Inverated/CAD/ama_notes.txt

I: 543                                         ~=====~ ~======= 
II: 543 + 41 + 5 = 589 (has bulge, losing 32cm) ====== =======<

OK. I'm wondering if the sails are big enough. what do you think?  At the moment, we two sails each 4.5m x 4.5m for a boat of LOA 9m.

300 (II)  343(I)  289
 <=====< ~====== =====>
