Inverated/CAD/docs/index.md

---
layout: default
title: Solar Proa - Wind-solar-powered Outrigger Boats
---

<div style="margin-bottom: 3em;">
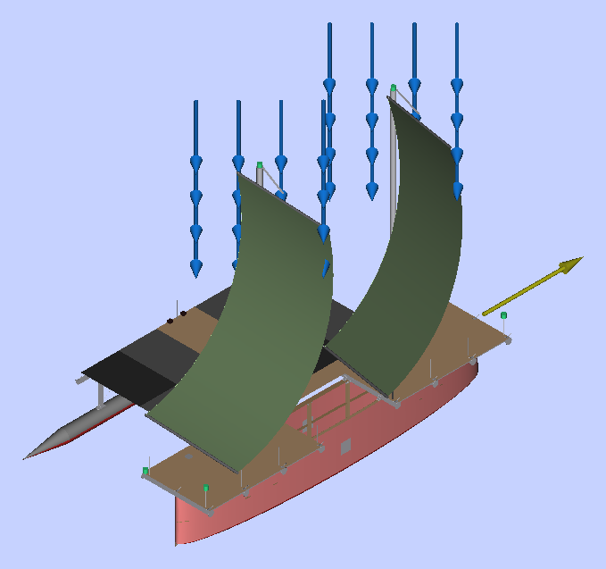
[picture p2: docs/renders/rp2.closehaul.render.isometric.png]
Roti Proa II - Solar-Electric Day Tourism Vessel
  
  <p style="text-align: center; color: #666; font-size: 0.9em; margin-top: 0.5em;">Roti Proa II - 9m solar-electric day tourism vessel</p>
</div>

## At a glance

Project _Solar Proa_ is developing wind-solar-powered hybrid vessels for carbon-neutral small-scale tropical maritime transport, exploration, and tourism.
The completion of our 9-meter minimal viable product _Roti Proa II_ is targeted for mid-2026 and strategic partnerships are available for commercial validation.

---

## The vision

Electric vehicle adoption across Asia has created new expectations for quiet, clean transportation - expectations that extend to maritime sector. Project Solar Proa is bringing carbon-neutral propulsion to water transport, island-hopping, snorkeling, and diving tourism with vessels that combine:

- **Traditional Design** - Inspired by Austronesian outrigger proas and Indonesian sailing 
- **Modern Engineering** - Parametric CAD design, aluminum construction, and efficient electric propulsion
- **Renewable Energy** - on-board photovoltaic energy harvesting with 4kW solar arrays providing continuous zero-emission operation in combination with traditional sails

---

## Our Vessels

<div style="display: grid; grid-template-columns: repeat(auto-fit, minmax(250px, 1fr)); gap: 2em; margin: 2em 0;">
  <div style="border: 1px solid #ddd; padding: 1.5em; border-radius: 8px;">
    <h3>Roti Proa I</h3>
    <p><strong>Status:</strong> Completed & Tested (2025)</p>
    <p><strong>Size:</strong> 4.2m prototype</p>
    <p><strong>Achievement:</strong> Proof of concept validated in Singapore waters</p>
    <p><a href="{{ '/rp1.html' | relative_url }}">View Details & Renders →</a></p>
  </div>
  
  <div style="border: 1px solid #ddd; padding: 1.5em; border-radius: 8px; background: #f8f8f8;">
    <h3>Roti Proa II</h3>
    <p><strong>Status:</strong> Under Construction</p>
    <p><strong>Size:</strong> 9m day tourism vessel</p>
    <p><strong>Capacity:</strong> 4 passengers + 2 crew</p>
    <p><strong>Target:</strong> June 2026 completion</p>
    <p><a href="{{ '/rp2.html' | relative_url }}">View Details & Renders →</a></p>
  </div>
  
  <div style="border: 1px solid #ddd; padding: 1.5em; border-radius: 8px;">
    <h3>Roti Proa III</h3>
    <p><strong>Status:</strong> Design Phase</p>
    <p><strong>Size:</strong> 13m multi-day vessel</p>
    <p><strong>Capacity:</strong> 5-6 passengers</p>
    <p><strong>Target:</strong> 2027 validation</p>
    <p><a href="{{ '/rp3.html' | relative_url }}">View Details & Renders →</a></p>
  </div>
</div>

---

## Why Tropical Southeast Asia?

**Exceptional solar irradiation** makes the region ideally suited for sustainable maritime propulsion. Our designs optimize traditional outrigger configurations to maximize solar panel area while maintaining excellent sailing characteristics.

The shunting, single-outrigger layout provides:
- Ample space for solar arrays between hull and outrigger
- Sail positioning that avoids casting shadows on panels
- Superior stability and efficiency for safe hybrid propulsion

---

## Commercial Opportunities

**Eco-Tourism Applications:**
- Short-distance passenger transport
- Island-hopping and coastal exploration
- Snorkeling and diving expeditions  
- Educational sailing experiences
- Wildlife observation cruises

**Operational Advantages:**
- Zero fuel costs and carbon emissions
- Significantly lower maintenance than diesel
- Quiet operation enhancing wildlife experiences
- Regulatory advantages from green certifications

**Market Position:**
At 10 knots under motor power, Roti Proa II targets the contemplative pace of eco-tourism - where the journey itself is part of the value proposition.

---

## Technical Innovation

All vessel designs are created using **parametric CAD modeling in FreeCAD and Python**, enabling:

- Novel boat designs optimized for solar-wind-hybrid propulsion
- Continuous power and weather monitoring for accurate arrival time prediction
- Rapid design iteration and optimization, version control and design transparency
- Open-source accessibility for educational purposes

**[Explore the CAD Models →]({{ '/downloads' | relative_url }})** | **[Under the Hood →]({{ '/technical.html' | relative_url }})**

---

## Current Status & Timeline

**Q1 2026:** Main hull delivery (9m Roti Proa II)  
**Q2 2026:** Final assembly and sea trials  
**Q3 2026:** Commercial validation with strategic partners  
**2027+:** Pilot production and 13m vessel development

---

## Partnerships

We are proud to work with [Dexteritas Pte Ltd](https://dexmarine.com/) also known as Dexmarine,
our electric marine propulsion partner who sponsors the electric propulsion
system for Roti Proa II.

<div style="margin-bottom: 3em;">
  Dexmarine - Marine Supply Service
</div>

We welcome further strategic partners for:

- **Field testing collaboration** and operational feedback
- **Joint development** of eco-tourism protocols
- **Co-branding opportunities** for sustainability leadership
- **CSR alignment** through maritime innovation support
- **Solar power systems** for exploring sustainable maritime transport

Partnership structures can be flexibly tailored to organizational priorities.

---

## Project Team

Project Solar Proa is a student project conducted at the School of Computing,
National University of Singapore.

**Team Members:**

- Chong Yew Mun Luke, Computer Science, MComp 2026

- Vikram Goyal, Computer Science, BComp 2027

- Kor Qian Fu, Business AI Systems, BComp 2028

- Lim Jia Yi (Julia), Business AI Systems, BComp 2028

- Ong Miao Ying, Clara, Robotics & Machine Intelligence, Second Major in Innovation & Design, BEng 2029 

- Tan Jia Jun, Mechanical Engineering, BEng 2027

**Technical Advisors:**

- [Livio Deltin](https://www.linkedin.com/in/livio-deltin-37936629/), Senior Naval Architect, MEng CEng (Pro Bono)

- [Marcel Eckhardt](https://www.linkedin.com/in/marcel-eckhardt-2607448a/), Electrical Engineer (Pro Bono)

- [Abdullah Farid](https://www.linkedin.com/in/abdullah-engineer/), Engineer, Wärtsilä Marine (Pro Bono)

- Jason Wong, Computer Scientist, BSc (Hons) Computer Science (Pro Bono)

**Project Coordinator:** [Martin Henz](https://www.linkedin.com/in/martin-henz/), Associate Professor, School of Computing, National University of Singapore

---

## Contact

**Email:** henz@nus.edu.sg  
**Institution:** School of Computing, National University of Singapore

---

<div style="text-align: center; padding: 2em 0; color: #666; font-size: 0.9em;">
  <p><em>Combining Southeast Asian maritime traditions with modern sustainable technology</em></p>
</div>
