Inverated/CAD/docs/id/rp2.md

---
layout: default
title: Roti Proa II - Kapal Wisata Harian 9m
description: Kapal Hibrida Bertenaga Angin-Surya untuk Daerah Tropis
lang: id
---

<div style="display: flex; align-items: center; gap: 2em; margin-bottom: 2em; flex-wrap: wrap;">
  <div style="flex: 1; min-width: 400px; max-width: 600px;">
    Roti Proa II Konstruksi
    <p style="font-size: 0.9em; color: #666; margin-top: 0.5em; font-style: italic;">Lambung utama Roti Proa II dalam konstruksi oleh Kim Tuck Huat Pte Ltd, 5/2/2026, Johor Bahru, Malaysia</p>
  </div>
</div>

[← Kembali ke Beranda]({{ '/id/' | relative_url }})

---

## Desain

Roti Proa II adalah kapal daysailer 9m yang menggabungkan rencana badan dasar proa Pasifik dengan material fiberglass, PVC, dan aluminium untuk mencapai konsep kapal yang dapat dikonfigurasi dan diskalakan.

**[Lihat Spesifikasi Desain Lengkap →]({{ '/id/design_rp2.html' | relative_url }})**

**Konstruksi Lambung:**
- Konstruksi fiberglass profesional oleh pembuat kapal Singapura
- Dioptimalkan untuk efisiensi propulsi listrik
- Pengiriman dijadwalkan pertengahan Februari 2026

**Sistem Surya-Listrik:**
- 8 x panel surya 500W (total 4kW)
- Sistem listrik 48V
- Motor listrik 4kW yang disponsori
- Manajemen baterai terintegrasi

**Rig Layar:**
- Dua tiang aluminium tanpa stay
- Layar persegi panjang terinspirasi tanja tradisional
- Konfigurasi shunting untuk kondisi tropis
- Kemampuan propulsi cadangan

**Cadik (Ama):**
- Konstruksi balok silang aluminium (aka)
- Konstruksi pelampung pipa PVC
- Pemasangan panel surya yang dioptimalkan
- Stabilitas yang ditingkatkan untuk kenyamanan penumpang

---

## Stabilitas & Daya Apung

Stabilitas kapal telah dianalisis menggunakan perhitungan kesetimbangan daya apung otomatis dan kurva GZ.

**[Lihat Analisis Stabilitas & Daya Apung Lengkap →]({{ '/id/stability_rp2.html' | relative_url }})**

| Parameter | Nilai | Deskripsi |
|---|---|---|
| Sarat | {{ site.data.rp2_beaching_buoyancy.equilibrium.z_offset_mm }} mm | Kedalaman di bawah garis air pada kesetimbangan |
| Lengan penegak maks | {{ site.data.rp2_beaching_gz.summary.max_gz_m | times: 100 | round: 0 }} cm | Pada kemiringan {{ site.data.rp2_beaching_gz.summary.max_gz_angle_deg }}° |
| Sudut capsize | {{ site.data.rp2_beaching_gz.summary.capsize_angle_deg }}° | Menjauhi ama |
| Sudut turtle | {{ site.data.rp2_beaching_gz.summary.turtle_angle_deg }}° | Menuju ama |
| Periode roll | {{ site.data.rp2_beaching_gz.natural_periods.roll_period_s }} s | Perkiraan kasar |
| Periode pitch | {{ site.data.rp2_beaching_gz.natural_periods.pitch_period_s }} s | Perkiraan kasar |
| Periode heave | {{ site.data.rp2_beaching_gz.natural_periods.heave_period_s }} s | Perkiraan kasar |

---

## Validasi Struktural

Integritas struktural kapal telah divalidasi di bawah beberapa skenario beban termasuk beban statis, dampak gelombang, gaya angin, dan operasi crane. Semua tes lulus dengan faktor keamanan melebihi minimum yang diperlukan yaitu 2,0.

**[Lihat Laporan Keselamatan Struktural Lengkap →]({{ '/id/validation_rp2.html' | relative_url }})**

| Tes | Faktor Keamanan | Hasil |
|-----|---|---|
| Ama tergantung (lentur aka) | {{ site.data.rp2_beaching_validate_structure.tests[0].summary.strong_axis.safety_factor }} | {{ site.data.rp2_beaching_validate_structure.tests[0].summary.strong_axis.result }} |
| Beban titik aka (kru berdiri) | {{ site.data.rp2_beaching_validate_structure.tests[1].summary.safety_factor }} | {{ site.data.rp2_beaching_validate_structure.tests[1].summary.result }} |
| Satu ujung ditopang (lentur spine) | {{ site.data.rp2_beaching_validate_structure.tests[2].summary.safety_factor }} | {{ site.data.rp2_beaching_validate_structure.tests[2].summary.result }} |
| Beban angin tiang (25 knot) | {{ site.data.rp2_beaching_validate_structure.tests[3].summary.safety_factor }} | {{ site.data.rp2_beaching_validate_structure.tests[3].summary.result }} |
| Penopang diagonal (lateral) | {{ site.data.rp2_beaching_validate_structure.tests[4].summary.min_safety_factor }} | {{ site.data.rp2_beaching_validate_structure.tests[4].summary.result }} |
| Hantaman gelombang (vertikal) | {{ site.data.rp2_beaching_validate_structure.tests[5].summary.min_safety_factor }} | {{ site.data.rp2_beaching_validate_structure.tests[5].summary.result }} |
| Hantaman gelombang frontal | {{ site.data.rp2_beaching_validate_structure.tests[6].summary.min_safety_factor }} | {{ site.data.rp2_beaching_validate_structure.tests[6].summary.result }} |
| Hantaman gelombang samping | {{ site.data.rp2_beaching_validate_structure.tests[7].summary.min_safety_factor }} | {{ site.data.rp2_beaching_validate_structure.tests[7].summary.result }} |
| Sling pengangkat (crane) | {{ site.data.rp2_beaching_validate_structure.tests[8].summary.min_safety_factor }} | {{ site.data.rp2_beaching_validate_structure.tests[8].summary.result }} |
| Beban gunwale | {{ site.data.rp2_beaching_validate_structure.tests[9].summary.min_safety_factor }} | {{ site.data.rp2_beaching_validate_structure.tests[9].summary.result }} |
| Kecepatan angin angkat ama | {{ site.data.rp2_beaching_validate_structure.tests[10].summary.ama_lift_windspeed_knots }} knot | INFO |

---

## Simulasi Kelistrikan

Sistem kelistrikan dimodelkan sebagai rangkaian DC panel surya–MPPT–baterai–motor. Simulasi menghitung titik operasi kondisi tunak, melakukan pengujian daya dan tingkat daya surya untuk memetakan batas sistem, dan menjalankan profil perjalanan multi-segmen untuk mengevaluasi daya tahan baterai dan batasan pengosongan dalam kondisi realistis.

**[Lihat Pengaturan Kelistrikan Lengkap & Hasil Simulasi →]({{ '/id/electrical_rp2.html' | relative_url }})**

## Status Proyek

**Fase Saat Ini:** Dalam Konstruksi

**Selesai:**
- ✅ Desain CAD detail dan optimasi
- ✅ Pesanan lambung ditempatkan ke pembuat kapal
- ✅ Struktur cadik sedang berlangsung
- ✅ Desain sistem listrik
- ✅ Pengadaan komponen

**Langkah Selanjutnya:**
- Pengiriman lambung (Februari 2026)
- Perakitan akhir (Maret-April 2026)
- Uji coba laut (Mei-Juni 2026)
- Validasi komersial dengan mitra (Q3 2026)

---

[← Kembali ke Beranda]({{ '/id/' | relative_url }}) | [Lihat RP1 →]({{ '/id/rp1.html' | relative_url }}) | [Lihat RP3 →]({{ '/id/rp3.html' | relative_url }})
