Inverated/CAD/docs/id/index.md

---
layout: default
title: Solar Proa - Perahu Cadik Bertenaga Angin-Surya
description: Kapal Hibrida Bertenaga Angin-Surya untuk Daerah Tropis
lang: id
---

<div style="margin-bottom: 3em;">
  Roti Proa II - Kapal Wisata Harian Bertenaga Surya-Listrik
  <p style="text-align: center; color: #666; font-size: 0.9em; margin-top: 0.5em;">Roti Proa II - Kapal wisata harian 9m bertenaga surya-listrik</p>
</div>

## Sekilas

Proyek _Solar Proa_ mengembangkan kapal hibrida bertenaga angin-surya untuk transportasi maritim tropis skala kecil yang ramah lingkungan, eksplorasi, dan pariwisata.
Penyelesaian produk minimal viable 9 meter kami, _Roti Proa II_, ditargetkan pertengahan 2026 dan kemitraan strategis tersedia untuk validasi komersial.

---

## Visi Kami

Adopsi kendaraan listrik di seluruh Asia telah menciptakan ekspektasi baru untuk transportasi yang tenang dan bersih - ekspektasi yang meluas ke sektor maritim. Proyek Solar Proa menghadirkan propulsi bebas karbon untuk transportasi air, wisata pulau, snorkeling, dan wisata selam dengan kapal yang menggabungkan:

- **Desain Tradisional** - Terinspirasi oleh proa cadik Austronesia dan pelayaran Indonesia
- **Rekayasa Modern** - Desain CAD parametrik, konstruksi aluminium, dan propulsi listrik efisien
- **Energi Terbarukan** - Pemanenan energi fotovoltaik di atas kapal dengan panel surya 4kW yang menyediakan operasi bebas emisi berkelanjutan dikombinasikan dengan layar tradisional

---

## Kapal Kami

<div style="display: grid; grid-template-columns: repeat(auto-fit, minmax(250px, 1fr)); gap: 2em; margin: 2em 0;">
  <div style="border: 1px solid #ddd; padding: 1.5em; border-radius: 8px;">
    <h3>Roti Proa I</h3>
    <p><strong>Status:</strong> Selesai & Teruji (2025)</p>
    <p><strong>Ukuran:</strong> Prototipe 4,2m</p>
    <p><strong>Pencapaian:</strong> Bukti konsep tervalidasi di perairan Singapura</p>
    <p><a href="{{ '/id/rp1.html' | relative_url }}">Lihat Detail & Render →</a></p>
  </div>

  <div style="border: 1px solid #ddd; padding: 1.5em; border-radius: 8px; background: #f8f8f8;">
    <h3>Roti Proa II</h3>
    <p><strong>Status:</strong> Dalam Konstruksi</p>
    <p><strong>Ukuran:</strong> Kapal wisata harian 9m</p>
    <p><strong>Kapasitas:</strong> 4 penumpang + 2 kru</p>
    <p><strong>Target:</strong> Selesai Juni 2026</p>
    <p><a href="{{ '/id/rp2.html' | relative_url }}">Lihat Detail & Render →</a></p>
  </div>

  <div style="border: 1px solid #ddd; padding: 1.5em; border-radius: 8px;">
    <h3>Roti Proa III</h3>
    <p><strong>Status:</strong> Fase Desain</p>
    <p><strong>Ukuran:</strong> Kapal multi-hari 13m</p>
    <p><strong>Kapasitas:</strong> 5-6 penumpang</p>
    <p><strong>Target:</strong> Validasi 2027</p>
    <p><a href="{{ '/id/rp3.html' | relative_url }}">Lihat Detail & Render →</a></p>
  </div>
</div>

---

## Mengapa Asia Tenggara Tropis?

**Iradiasi surya yang luar biasa** menjadikan kawasan ini sangat cocok untuk propulsi maritim berkelanjutan. Desain kami mengoptimalkan konfigurasi cadik tradisional untuk memaksimalkan area panel surya sambil mempertahankan karakteristik pelayaran yang sangat baik.

Tata letak shunting dengan cadik tunggal menyediakan:
- Ruang yang luas untuk panel surya antara lambung dan cadik
- Posisi layar yang menghindari bayangan pada panel
- Stabilitas dan efisiensi superior untuk propulsi hibrida yang aman

---

## Peluang Komersial

**Aplikasi Eko-Wisata:**
- Transportasi penumpang jarak pendek
- Wisata pulau dan eksplorasi pesisir
- Ekspedisi snorkeling dan selam
- Pengalaman pelayaran edukatif
- Wisata pengamatan satwa liar

**Keunggulan Operasional:**
- Nol biaya bahan bakar dan emisi karbon
- Perawatan jauh lebih rendah dibanding diesel
- Operasi tenang meningkatkan pengalaman satwa liar
- Keunggulan regulasi dari sertifikasi hijau

**Posisi Pasar:**
Dengan kecepatan 10 knot di bawah tenaga motor, Roti Proa II menargetkan tempo kontemplatif eko-wisata - di mana perjalanan itu sendiri adalah bagian dari proposisi nilai.

---

## Inovasi Teknis

Semua desain kapal dibuat menggunakan **pemodelan CAD parametrik di FreeCAD dan Python**, memungkinkan:

- Desain kapal novel yang dioptimalkan untuk propulsi hibrida surya-angin
- Pemantauan daya dan cuaca berkelanjutan untuk prediksi waktu kedatangan yang akurat
- Iterasi dan optimasi desain yang cepat, kontrol versi dan transparansi desain
- Aksesibilitas sumber terbuka untuk tujuan pendidikan

**[Jelajahi Model CAD →]({{ '/downloads' | relative_url }})** | **[Di Balik Layar →]({{ '/id/technical.html' | relative_url }})**

---

## Status Terkini & Linimasa

**Q1 2026:** Pengiriman lambung utama (Roti Proa II 9m)
**Q2 2026:** Perakitan akhir dan uji coba laut
**Q3 2026:** Validasi komersial dengan mitra strategis
**2027+:** Produksi percontohan dan pengembangan kapal 13m

---

## Kemitraan

Kami bangga bekerja sama dengan [Dexteritas Pte Ltd](https://dexmarine.com/) yang juga dikenal sebagai Dexmarine,
mitra propulsi maritim listrik kami yang mensponsori sistem propulsi listrik
untuk Roti Proa II.

<div style="margin-bottom: 3em;">
  Dexmarine - Marine Supply Service
</div>

Kami menyambut mitra strategis lebih lanjut untuk:

- **Kolaborasi uji lapangan** dan umpan balik operasional
- **Pengembangan bersama** protokol eko-wisata
- **Peluang co-branding** untuk kepemimpinan keberlanjutan
- **Keselarasan CSR** melalui dukungan inovasi maritim
- **Sistem tenaga surya** untuk mengeksplorasi transportasi maritim berkelanjutan

Struktur kemitraan dapat disesuaikan secara fleksibel dengan prioritas organisasi.

---

## Tim Proyek

Proyek Solar Proa adalah proyek mahasiswa yang dilakukan di Sekolah Komputasi,
Universitas Nasional Singapura (School of Computing,
National University of Singapore).

**Anggota Tim:**

- Chong Yew Mun Luke, Computer Science, MComp 2026

- Vikram Goyal, Computer Science, BComp 2027

- Kor Qian Fu, Business AI Systems, BComp 2028

- Lim Jia Yi (Julia), Business AI Systems, BComp 2028

- Ong Miao Ying, Clara, Robotics & Machine Intelligence, Second Major in Innovation & Design, BEng 2029

- Tan Jia Jun, Mechanical Engineering, BEng 2027

**Penasihat Teknis:**

- [Livio Deltin](https://www.linkedin.com/in/livio-deltin-37936629/), Senior Naval Architect, MEng CEng (Pro Bono)

- [Marcel Eckhardt](https://www.linkedin.com/in/marcel-eckhardt-2607448a/), Electrical Engineer (Pro Bono)

- [Abdullah Farid](https://www.linkedin.com/in/abdullah-engineer/), Engineer, Wärtsilä Marine (Pro Bono)

- Jason Wong, Computer Scientist, BSc (Hons) Computer Science (Pro Bono)

**Koordinator Proyek:** [Martin Henz](https://www.linkedin.com/in/martin-henz/), Associate Professor, School of Computing, National University of Singapore

---

## Kontak

**Email:** henz@nus.edu.sg
**Institusi:** School of Computing, National University of Singapore

---

<div style="text-align: center; padding: 2em 0; color: #666; font-size: 0.9em;">
  <p><em>Menggabungkan tradisi maritim Asia Tenggara dengan teknologi berkelanjutan modern</em></p>
</div>
