Inverated/CAD/docs/id/rp1.md

---
layout: default
title: Roti Proa I - Prototipe 4,2m
lang: id
---

<div style="display: flex; align-items: center; gap: 2em; margin-bottom: 2em; flex-wrap: wrap;">
  <div style="flex: 1; min-width: 500px; max-width: 700px;">
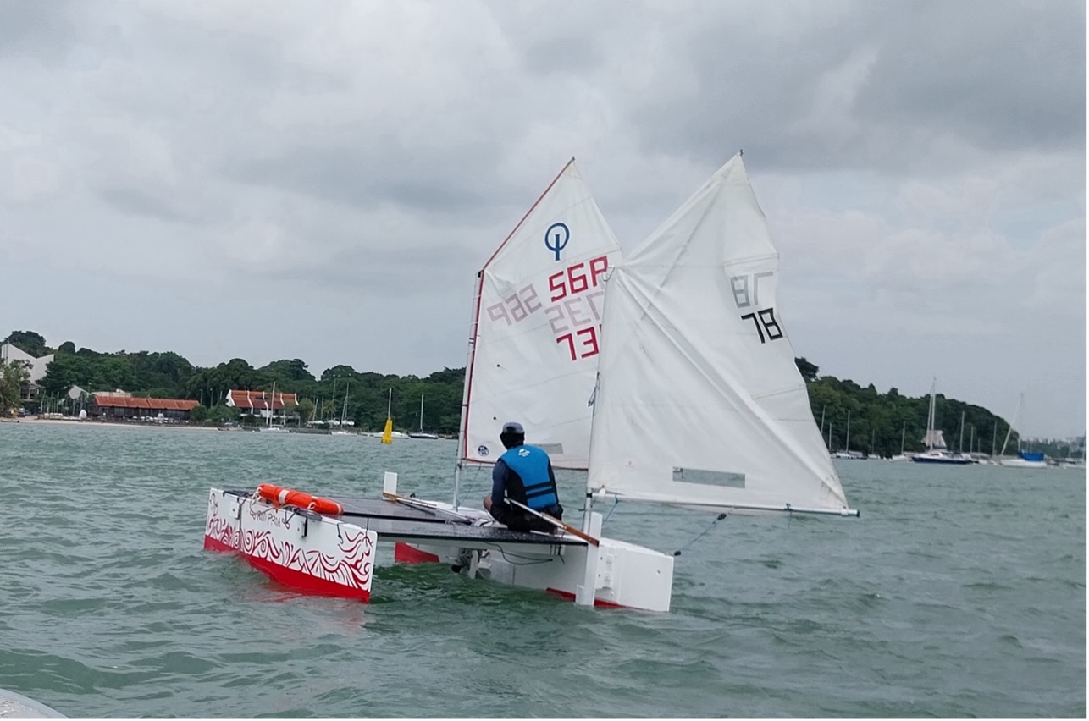
[picture p3: docs/images/rp1.jpg]
Roti Proa I
    
    <p style="font-size: 0.9em; color: #666; margin-top: 0.5em; font-style: italic;">Roti Proa I, dinahkodai oleh Penasihat Solar Proa Abdullah Farid, melakukan uji performa pada 30 Mei 2025</p>
  </div>
</div>

[← Kembali ke Beranda]({{ '/id/' | relative_url }})

---

## Ringkasan

**Status:** ✅ Selesai dan teruji (Desember 2024 - Juni 2025)

Roti Proa I adalah prototipe bukti-konsep kami yang memvalidasi kelayakan menggabungkan desain cadik tradisional dengan propulsi surya-listrik modern di perairan tropis. Kapal 4,2 meter ini berhasil mendemonstrasikan prinsip-prinsip inti yang menginformasikan desain komersial kami yang lebih besar.

**Pencapaian Utama:**
- **Uji coba laut tervalidasi** di perairan Singapura dekat Changi
- **Kecepatan tertinggi:** 6,5 knot (12 km/jam) dengan tenaga listrik
- **Kapasitas surya:** 1 kW puncak (2 panel)
- **Propulsi:** Motor tempel listrik 2 kW
- **Baterai:** 2 x 50 Ah, LiFePO₄
- **Rig layar:** Dua rig sport independen (Optimist) untuk konfigurasi eksperimental

Prototipe ini membuktikan bahwa proa surya layak untuk perairan Asia Tenggara tropis dan memberikan data penting untuk peningkatan skala ke desain Roti Proa II 9 meter.

---

## Publikasi Unggulan

Untuk laporan detail tentang pengembangan, pengujian, dan pelajaran yang dipetik dari Roti Proa I, baca artikel lengkap yang diterbitkan oleh Changi Sailing Club di Singapura:

**[Roti Proa: Perahu Eksperimental Bertenaga Angin dan Surya](https://www.csc.org.sg/2025/07/11/roti-proa-an-experimental-wind-and-solar-powered-boat/)**

Artikel komprehensif ini mencakup:
- Filosofi desain dan pengaruh tradisional
- Proses konstruksi dan pilihan material
- Hasil uji coba laut dan data performa
- Pelajaran yang dipetik untuk pengembangan masa depan
- Tantangan teknis dan solusinya

---

## Spesifikasi Ringkas

| Spesifikasi | Nilai |
|---|---|
| Panjang Keseluruhan (LOA) | 4,2m |
| Lebar | 2,5m |
| Daya Surya | 1kW puncak |
| Daya Motor | Motor tempel listrik 2kW |
| Tipe Baterai | LiFePO₄ |
| Kecepatan Tertinggi | 6,5 knot |
| Kru | 1-2 orang |
| Status | Pengujian selesai Juni 2025 |

---

## Warisan & Dampak

Uji coba Roti Proa I yang sukses memberikan kepercayaan dan data empiris yang diperlukan untuk mengejar pengembangan skala komersial. Prototipe ini mendemonstrasikan bahwa:

✅ Propulsi surya-listrik layak di perairan tropis
✅ Desain cadik tradisional beradaptasi dengan baik terhadap sistem listrik modern
✅ Proa shunting dapat mengintegrasikan panel surya secara efektif
✅ Kombinasi ini menciptakan pengalaman eko-wisata yang menarik

Wawasan ini secara langsung menginformasikan desain Roti Proa II dan memvalidasi pendekatan kami untuk Roti Proa III 13 meter.

---

## Pendanaan & Dukungan

Roti Proa I didanai melalui:
- **Maybank Green Fund:** S$5.000 (melalui NUS Office of Student Affairs)
- **Donasi dan sponsor swasta:** S$7.000
- **Total biaya proyek:** S$12.000

---

[← Kembali ke Beranda]({{ '/id/' | relative_url }}) | [Lihat RP2 →]({{ '/id/rp2.html' | relative_url }}) | [Lihat RP3 →]({{ '/id/rp3.html' | relative_url }})
