Inverated/CAD/docs/images/circuit_diagrams_temp/Sensor Reader V3-Microcontroller.png

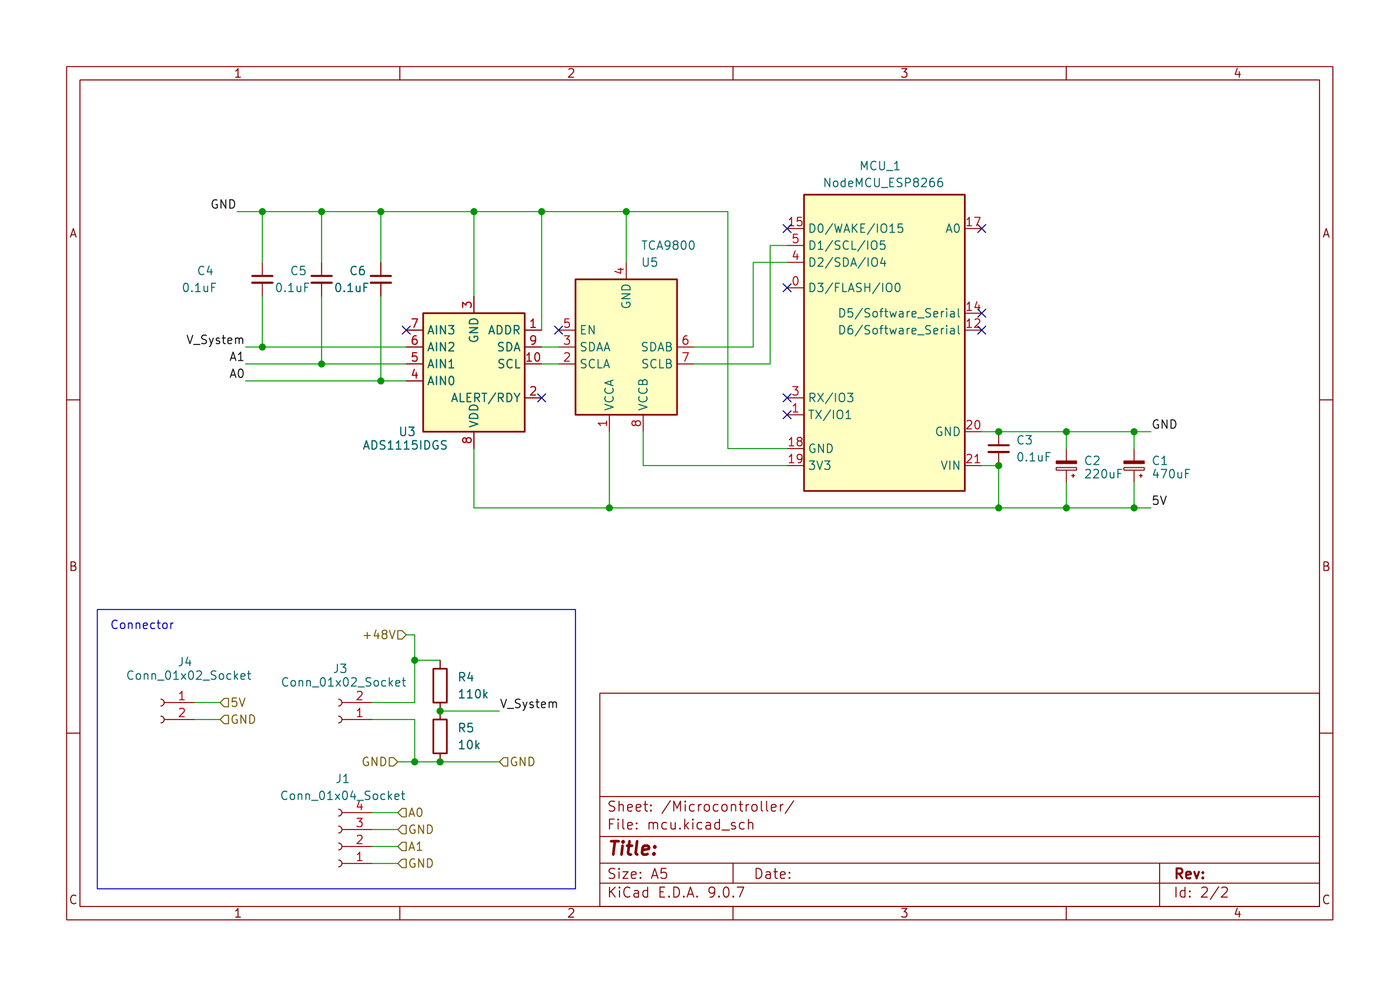
docs/images/circuit_diagrams_temp/Sensor Reader V3-Microcontroller.png
