Inverated/CAD/docs/images/circuit_diagrams_temp/Sensor Reader V3.png

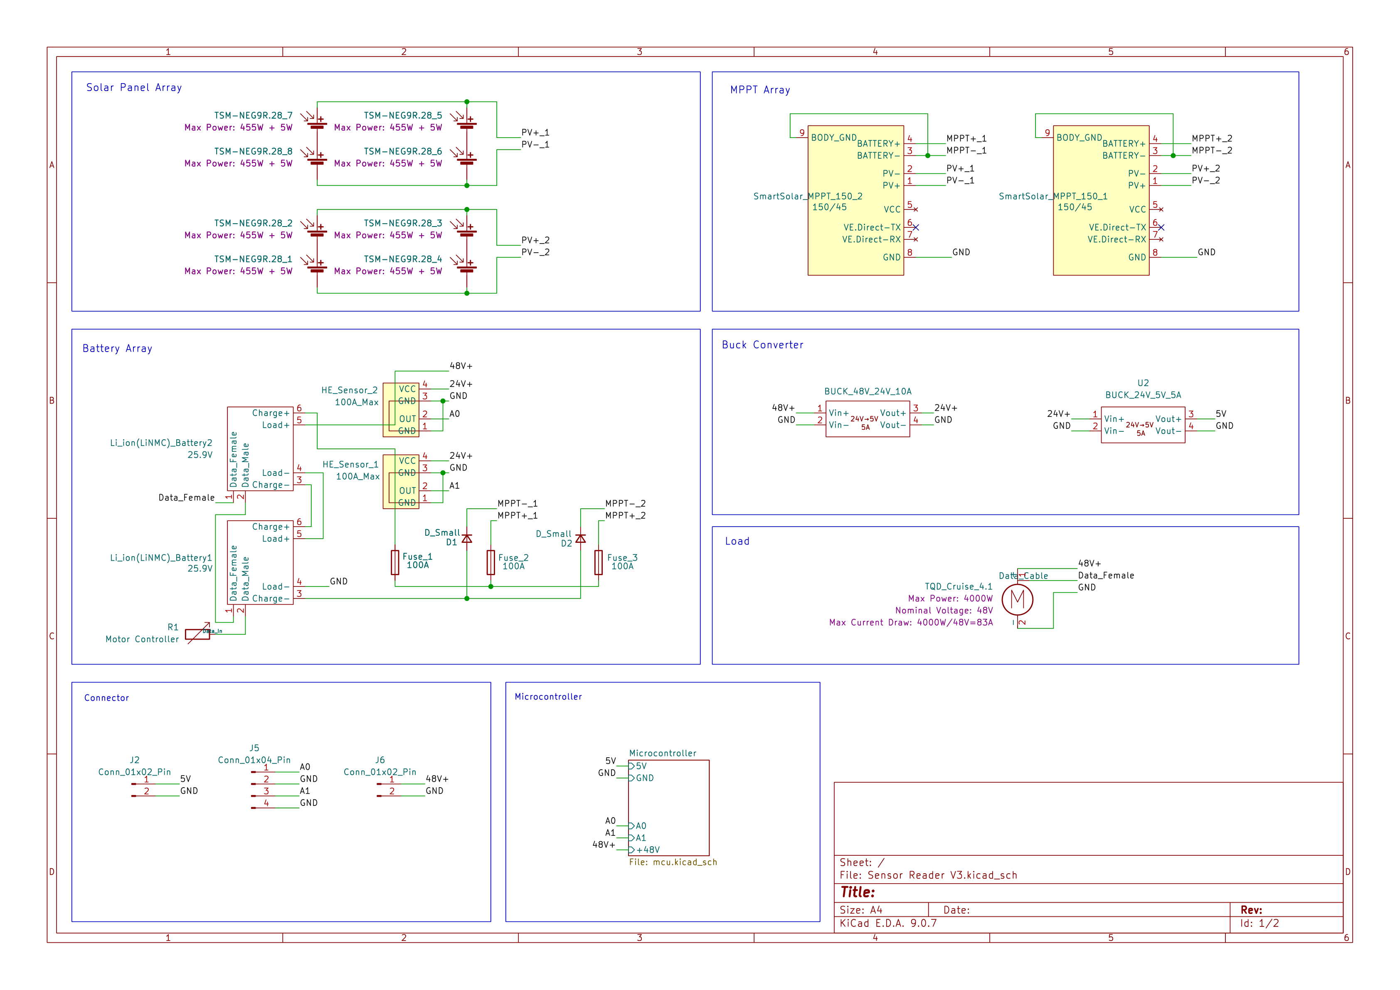
docs/images/circuit_diagrams_temp/Sensor Reader V3.png
