Inverated/CAD/src/circuit_diagram/KiCad/proa_2_circuit_diagram/pdf_converted.png

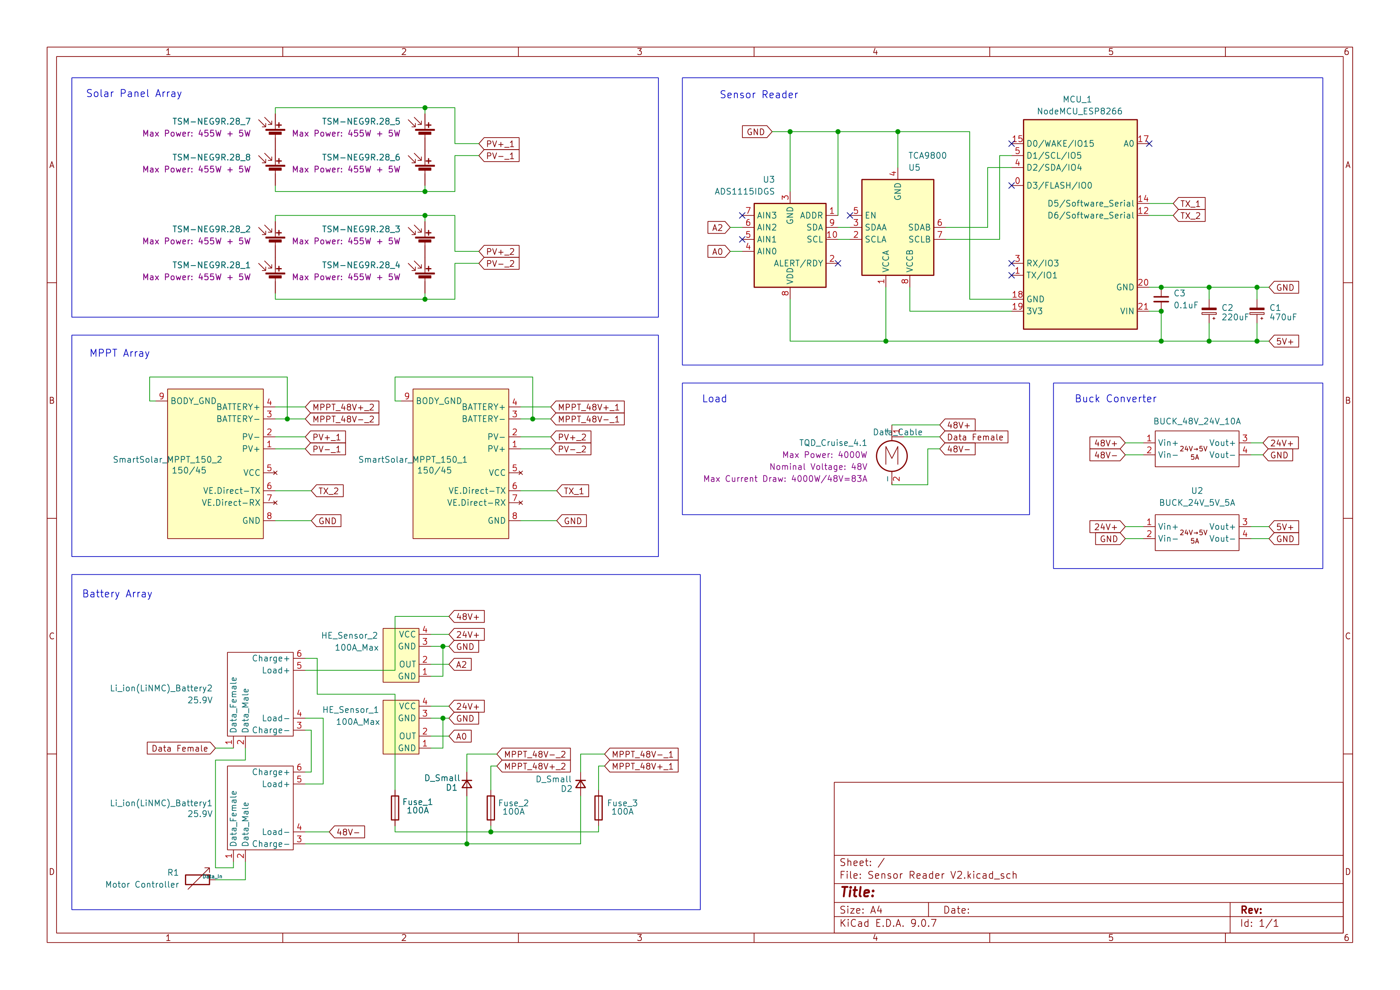
src/circuit_diagram/KiCad/proa_2_circuit_diagram/pdf_converted.png
