Inverated/CAD/docs/downloads/rp2.closehaul.step.step

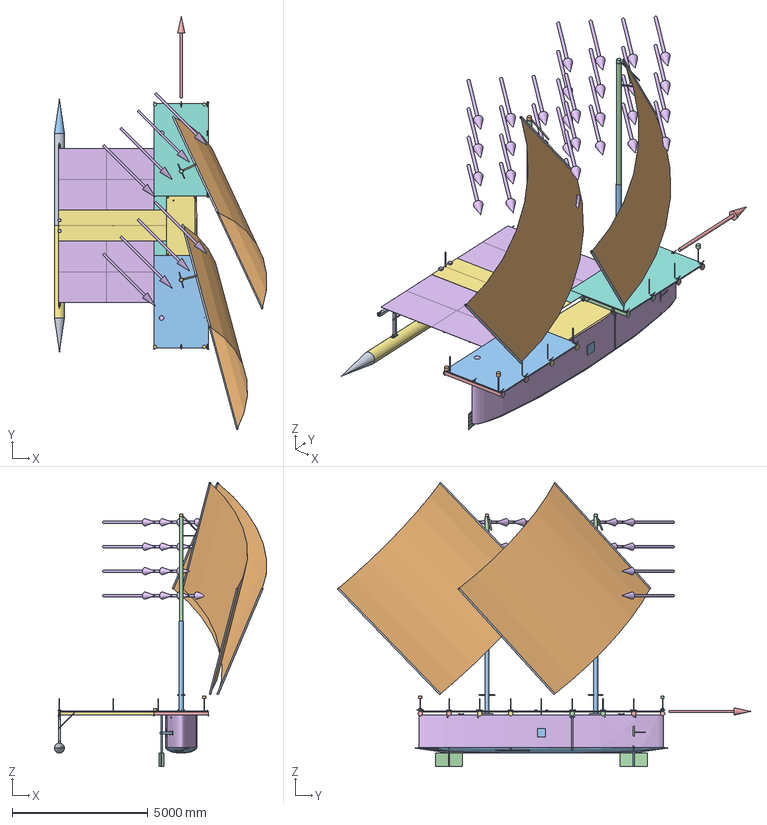
[picture p9: CAD file, 2026-02-18, last stored version]
docs/downloads/rp2.closehaul.step.step
7812.3 x 15208.9 x 10471.8 mm
Overhead__plywood_ x 2
Bottom__fiberglass_bottom_ x 2
Foam_Below_Sole__foam_ x 2
Sole__plywood_ x 2
Air_Inside_Vaka__air_ x 2
Outer_Crossdeck_Stanchion__steel_ x 2
Center_Crossdeck_Stanchion__aluminum_ x 2
Motor_Backing_Plate__aluminum_ x 2
Side_Board_Plate__aluminum_ x 2
X-axis x 24
XY-plane x 24
Aka_1__aluminum_ x 2
Stanchion_1__steel_ x 2
Cleat__steel_ x 2
Frame_1__plywood_ x 2
Bottom_Frame_1__plywood_ x 2
Gusset_clamp_to_aka_right_1__aluminum_ x 2
Gusset_clamp_to_aka_left_1__aluminum_ x 2
Gusset_frame_to_clamp_right_1__aluminum_ x 2
Gusset_frame_to_clamp_left_1__aluminum_ x 2
Gusset_clamp_to_aka_outer_right_1__aluminum_ x 2
Gusset_clamp_to_aka_outer_left_1__aluminum_ x 2
Gusset_frame_to_clamp_outer_right_1__aluminum_ x 2
Gusset_frame_to_clamp_outer_left_1__aluminum_ x 2
Gusset_spine_to_aka_right_1__aluminum_ x 2
Gusset_spine_to_aka_left_1__aluminum_ x 2
Gusset_pillar_to_spine_right_1__aluminum_ x 2
Gusset_pillar_to_spine_left_1__aluminum_ x 2
Gusset_pillar_to_ama_top_right_1__aluminum_ x 2
Gusset_pillar_to_ama_top_left_1__aluminum_ x 2
Gusset_pillar_to_ama_bottom_right_1__aluminum_ x 2
Gusset_pillar_to_ama_bottom_left_1__aluminum_ x 2
Gusset_pillar_to_ama_inside_right_1__aluminum_ x 2
Gusset_pillar_to_ama_inside_left_1__aluminum_ x 2
Aka_2__aluminum_ x 2
Stanchion_2__steel_ x 2
Cleat__steel_001 x 2
Frame_2__plywood_ x 2
Bottom_Frame_2__plywood_ x 2
Gusset_clamp_to_aka_right_2__aluminum_ x 2
Gusset_clamp_to_aka_left_2__aluminum_ x 2
Gusset_frame_to_clamp_right_2__aluminum_ x 2
Gusset_frame_to_clamp_left_2__aluminum_ x 2
Gusset_clamp_to_aka_outer_right_2__aluminum_ x 2
Gusset_clamp_to_aka_outer_left_2__aluminum_ x 2
Gusset_frame_to_clamp_outer_right_2__aluminum_ x 2
Gusset_frame_to_clamp_outer_left_2__aluminum_ x 2
Gusset_spine_to_aka_right_2__aluminum_ x 2
Gusset_spine_to_aka_left_2__aluminum_ x 2
Gusset_pillar_to_spine_right_2__aluminum_ x 2
Gusset_pillar_to_spine_left_2__aluminum_ x 2
Gusset_pillar_to_ama_top_right_2__aluminum_ x 2
Gusset_pillar_to_ama_top_left_2__aluminum_ x 2
Gusset_pillar_to_ama_bottom_right_2__aluminum_ x 2
Gusset_pillar_to_ama_bottom_left_2__aluminum_ x 2
Gusset_pillar_to_ama_inside_right_2__aluminum_ x 2
Gusset_pillar_to_ama_inside_left_2__aluminum_ x 2
Aka_3__aluminum_ x 2
Stanchion_3__steel_ x 2
Cleat__steel_002 x 2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
