Inverated/CAD/src/circuit_diagram/KiCad/proa_2_circuit_diagram/proa_2_circuit_diagram.kicad_pcb

## KiCad design V1.2/v1.2_kicad/v1.2_kicad.kicad_sch

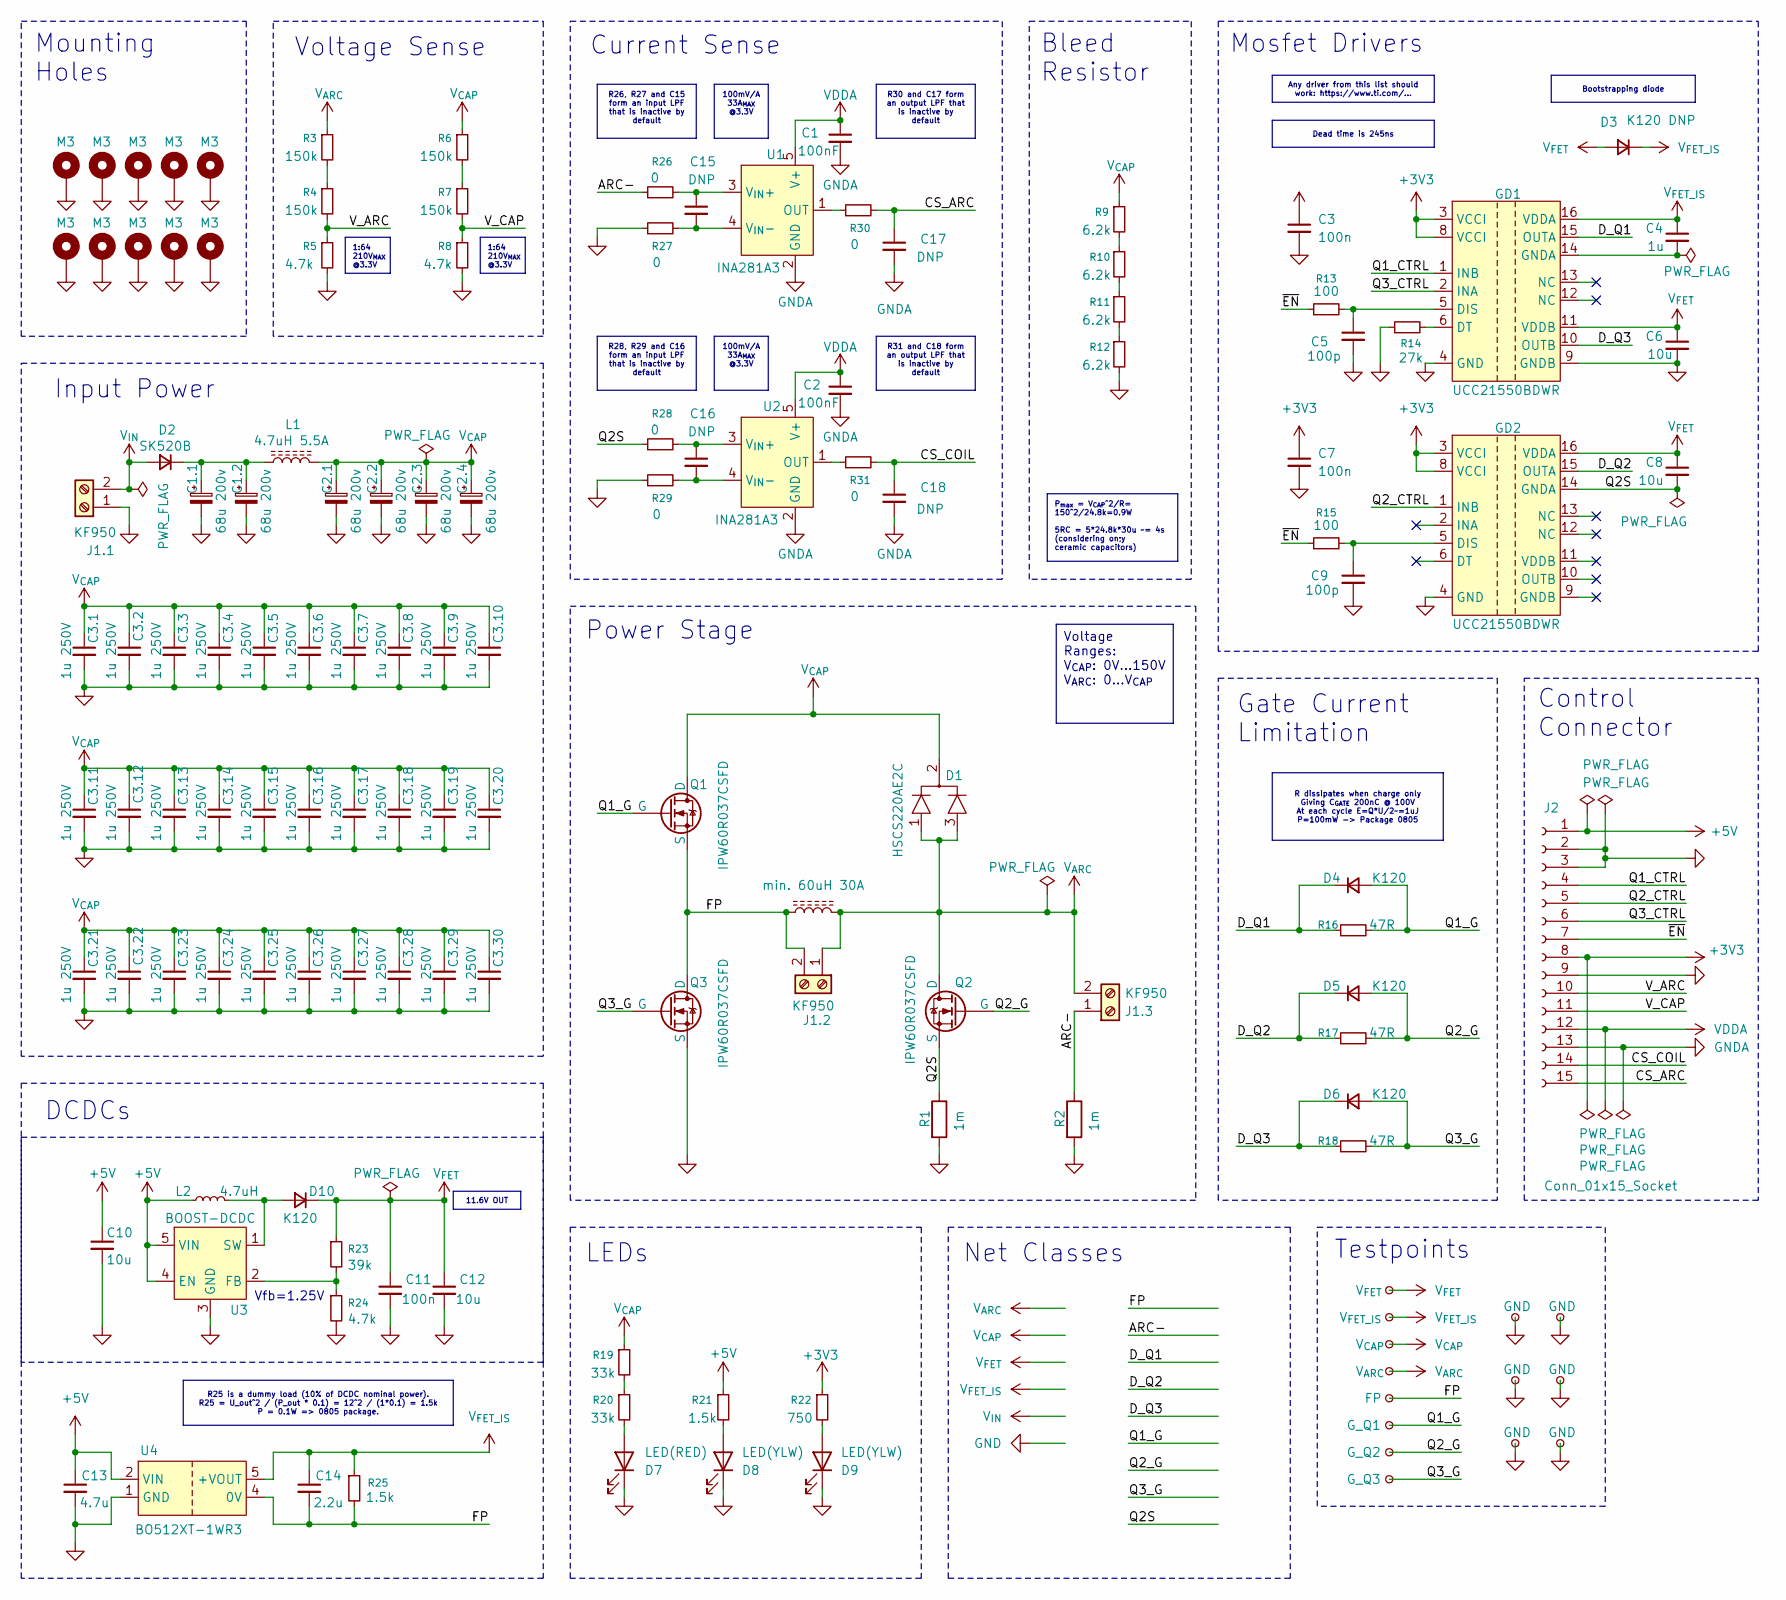
[picture p10: schematic v1.2_kicad.kicad_sch]

Parts:
C1, C2: 100nF
C1.1, C1.2, C2.1, C2.2, C2.3, C2.4: 68u 200v
C3, C7, C11: 100n
C3.1, C3.2, C3.3, C3.4, C3.5, C3.6, C3.7, C3.8, C3.9, C3.10, C3.11, C3.12, C3.13, C3.14, C3.15, C3.16, C3.17, C3.18, C3.19, C3.20, C3.21, C3.22, C3.23, C3.24, C3.25, C3.26, C3.27, C3.28, C3.29, C3.30: 1u 250V
C4: 1u
C5, C9: 100p
C6, C8, C10, C12: 10u
C13: 4.7u
C14: 2.2u
C15, C16, C17, C18: DNP
D1: HSCS220AE2C
D2: SK520B
D3: K120 DNP
D4, D5, D6, D10: K120
D7: LED(RED)
D8, D9: LED(YLW)
GD1, GD2: UCC21550BDWR
H1, H2, H3, H4, H5, H6, H7, H8, H9, H10: M3
J1.1, J1.2, J1.3: KF950
J2: Conn_01x15_Socket
L1: 4.7uH 5.5A
L2: 4.7uH
L3: min. 60uH 30A
Q1, Q2, Q3: IPW60R037CSFD
R1, R2: 1m
R3, R4, R6, R7: 150k
R5, R8, R24: 4.7k
R9, R10, R11, R12: 6.2k
R13, R15: 100
R14: 27k
R16, R17, R18: 47R
R19, R20: 33k
R21, R25: 1.5k
R22: 750
R23: 39k
R26, R27, R28, R29, R30, R31: 0
TP1, TP2, TP3, TP4, TP5, TP6: GND
TP7: V_{FET}
TP8: V_{FET_IS}
TP9: V_{CAP}
TP10: V_{ARC}
TP11: FP
TP12: G_Q1
TP13: G_Q2
TP14: G_Q3
U1, U2: INA281A3
U3: BOOST-DCDC
U4: BO512XT-1WR3

Connections:
+3V3: C3.1, C7.1, GD1.3 (VCCI), GD1.8 (VCCI), GD2.3 (VCCI), GD2.8 (VCCI), J2.8, R22.1
+5V: C10.1, C13.1, J2.1, L2.1, R21.1, U3.4 (EN), U3.5 (VIN), U4.2 (VIN)
ARC-: J1.3.1, R2.1, R26.1
CS_ARC: C17.1, J2.15, R30.2
CS_COIL: C18.1, J2.14, R31.2
D_Q1: D4.1 (K), GD1.15 (OUTA), R16.1
D_Q2: D5.1 (K), GD2.15 (OUTA), R17.1
D_Q3: D6.1 (K), GD1.10 (OUTB), R18.1
FP: C14.2, J1.2.2, L3.1, Q1.3 (S), Q3.1 (D), R25.2, TP11.1, U4.4 (0V)
GND: C1.1.2, C1.2.2, C2.1.2, C2.2.2, C2.3.2, C2.4.2, C3.2, C3.1.2, C3.2.2, C3.3.2, C3.4.2, C3.5.2, C3.6.2, C3.7.2, C3.8.2, C3.9.2, C3.10.2, C3.11.2, C3.12.2, C3.13.2, C3.14.2, C3.15.2, C3.16.2, C3.17.2, C3.18.2, C3.19.2, C3.20.2, C3.21.2, C3.22.2, C3.23.2, C3.24.2, C3.25.2, C3.26.2, C3.27.2, C3.28.2, C3.29.2, C3.30.2, C5.2, C6.2, C7.2, C9.2, C10.2, C11.2, C12.2, C13.2, D7.1 (K), D8.1 (K), D9.1 (K), GD1.4 (GND), GD1.9 (GNDB), GD2.4 (GND), H1.1, H2.1, H3.1, H4.1, H5.1, H6.1, H7.1, H8.1, H9.1, H10.1, J1.1.1, J2.2, J2.3, J2.9, Q3.3 (S), R1.2, R2.2, R5.2, R8.2, R12.2, R14.1, R24.2, R27.1, R29.1, TP1.1, TP2.1, TP3.1, TP4.1, TP5.1, TP6.1, U3.3 (GND), U4.1 (GND)
GNDA: C1.2, C2.2, C17.2, C18.2, J2.13, U1.2 (GND), U2.2 (GND)
unnamed: C1.1.1, C1.2.1, D2.1 (K), L1.1
unnamed: C4.2, GD1.14 (GNDA)
unnamed: C5.1, GD1.5 (DIS), R13.2
unnamed: C9.1, GD2.5 (DIS), R15.2
unnamed: C15.1, R26.2, U1.3 (V_{IN}+)
unnamed: C15.2, R27.2, U1.4 (V_{IN}-)
unnamed: C16.1, R28.2, U2.3 (V_{IN}+)
unnamed: C16.2, R29.2, U2.4 (V_{IN}-)
unnamed: D7.2 (A), R20.2
unnamed: D8.2 (A), R21.2
unnamed: D9.2 (A), R22.2
unnamed: D10.2 (A), L2.2, U3.1 (SW)
unnamed: GD1.6 (DT), R14.2
unnamed: R3.2, R4.1
unnamed: R6.2, R7.1
unnamed: R9.2, R10.1
unnamed: R10.2, R11.1
unnamed: R11.2, R12.1
unnamed: R19.2, R20.1
unnamed: R23.2, R24.1, U3.2 (FB)
unnamed: R30.1, U1.1 (OUT)
unnamed: R31.1, U2.1 (OUT)
Q1_CTRL: GD1.1 (INB), J2.4
Q1_G: D4.2 (A), Q1.2 (G), R16.2, TP12.1
Q2S: C8.2, GD2.14 (GNDA), Q2.3 (S), R1.1, R28.1
Q2_CTRL: GD2.1 (INB), J2.5
Q2_G: D5.2 (A), Q2.2 (G), R17.2, TP13.1
Q3_CTRL: GD1.2 (INA), J2.6
Q3_G: D6.2 (A), Q3.2 (G), R18.2, TP14.1
VDDA: C1.1, C2.1, J2.12, U1.5 (V+), U2.5 (V+)
V_ARC: J2.10, R4.2, R5.1
V_CAP: J2.11, R7.2, R8.1
V_{ARC}: D1.1, D1.3, J1.2.1, J1.3.2, L3.2, Q2.1 (D), R3.1, TP10.1
V_{CAP}: C2.1.1, C2.2.1, C2.3.1, C2.4.1, C3.1.1, C3.2.1, C3.3.1, C3.4.1, C3.5.1, C3.6.1, C3.7.1, C3.8.1, C3.9.1, C3.10.1, C3.11.1, C3.12.1, C3.13.1, C3.14.1, C3.15.1, C3.16.1, C3.17.1, C3.18.1, C3.19.1, C3.20.1, C3.21.1, C3.22.1, C3.23.1, C3.24.1, C3.25.1, C3.26.1, C3.27.1, C3.28.1, C3.29.1, C3.30.1, D1.2, L1.2, Q1.1 (D), R6.1, R9.1, R19.1, TP9.1
V_{FET_IS}: C4.1, C14.1, D3.1 (K), GD1.16 (VDDA), R25.1, TP8.1, U4.5 (+VOUT)
V_{FET}: C6.1, C8.1, C11.1, C12.1, D3.2 (A), D10.1 (K), GD1.11 (VDDB), GD2.16 (VDDA), R23.1, TP7.1
V_{IN}: D2.2 (A), J1.1.2
~EN: J2.7, R13.1, R15.1

Notes on the sheet:
Current Sense
LEDs
Testpoints
Voltage Sense
Input Power
Bleed Resistor
DCDCs
Net Classes
Power Stage
Vfb=1.25V
Control Connector
Gate Current Limitation
Mosfet Drivers
Mounting Holes
P_{max} = V_{CAP}^2/R= 150^2/24.8k=0.9W 5RC = 5*24.8k*30u ~= 4s (considering on;y ceramic capacitors)
Voltage Ranges: V_{CAP}: 0V...150V V_{ARC}: 0...V_{CAP}
R dissipates when charge only Giving C_{GATE} 200nC @ 100V At each cycle E=Q*U/2~=1uJ P=100mW -> Package 0805
100mV/A 33A_{MAX} @3.3V
1:64 210V_{MAX} @3.3V
R26, R27 and C15 form an input LPF that is inactive by default
11.6V OUT
Bootstrapping diode
R31 and C18 form an output LPF that is inactive by default
Dead time is 245ns
R30 and C17 form an output LPF that is inactive by default
Any driver from this list should work: https://www.ti.com/...
R25 is a dummy load (10% of DCDC nominal power). R25 = U_out^2 / (P_out * 0.1) = 12^2 / (1*0.1) = 1.5k P = 0.1W => 0805 package.
R28, R29 and C16 form an input LPF that is inactive by default
