Inverated/CAD/(commit log)

2026-01-15 Add akas_per_panel parameter for multiple akas under each panel
    Support configurable number of akas per panel row, similar to rudder ribs:
    - Add akas_per_panel and aka_rim parameters to boat JSON files
    - Add aka_y_position() function for consistent aka positioning
    - Update cockpit_length calculation to start deck at first aka
    - Update ama_cone_length to start cone at outer pillar edge
    - Update rudder mount positions to use last aka position
    - Add checkered pattern for solar panels (alternating colors)
    - Add new material colors for bottom surfaces (red pvc, fiberglass)
2026-01-17 Data-driven view configuration for renders
    - Add constant/view.json with view definitions (name, display_name, freecad_method)
    - Update render scripts to read views from config file
    - Update templates to use site.data.view[name].display_name
    - Fix config filtering: closehaul no longer matches closehaulreefed
    - Workflow copies view.json to docs/_data/ during build
    Adding a new view to view.json will automatically generate and display it.
2026-02-16 Added KiCad Schematics
    [proa_2_circuit_diagram.kicad_pcb, proa_2_circuit_diagram.kicad_sch]
2026-02-17 Update makefile for electrical config
    - Added 'all' simulation type
    - Setup rp1-3 circuit config
    - Fixed output file path
2026-02-17 Pin shipshape==0.7.0
    Picks up geometry abstraction layer and validate_structure removal.
2026-02-18 Complete webpage for electrical simulation
    [rp2.beaching.step.step, rp2.closehaul.step.step]
2026-02-18 Post processing filter
2026-02-18 Remove generated files and update gitignore
    [proa_2_circuit_diagram.kicad_pcb, proa_2_circuit_diagram.kicad_sch, rp2.beaching.step.step, rp2.closehaul.step.step]
2026-03-07 Update circuit design
